Warakorn456/project-sau/wiring_with_float-1.jpg

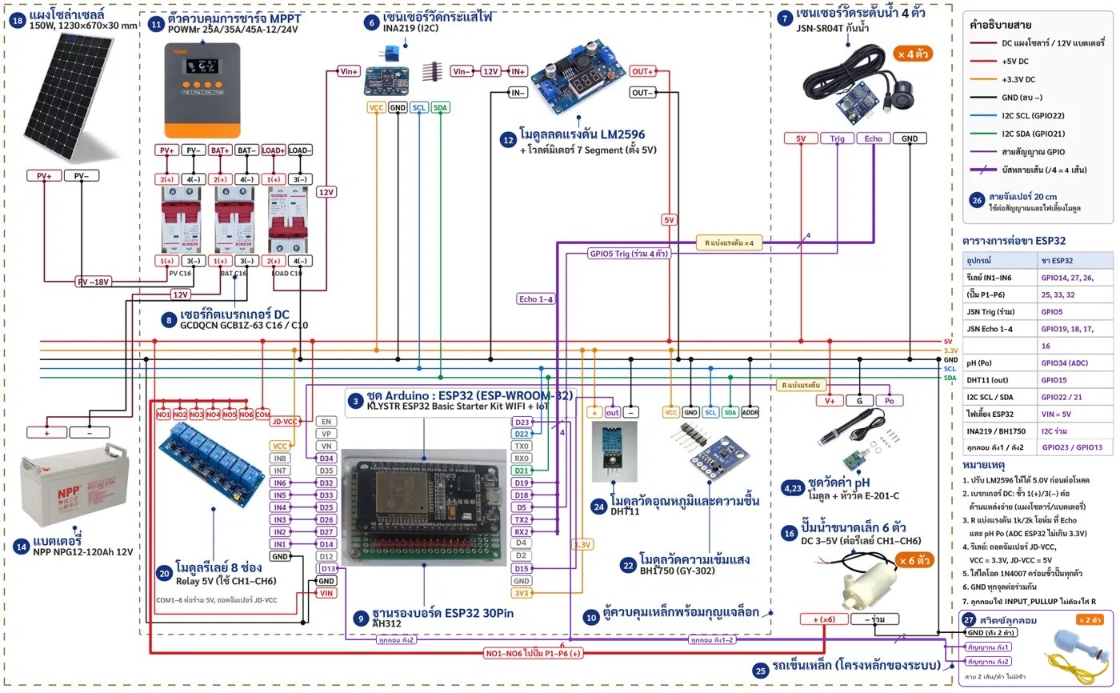
wiring_with_float-1.jpg
