Warakorn456/project-sau/เล่มโปรเจ็ค/รูปบทที่3/part_lm7seg.png

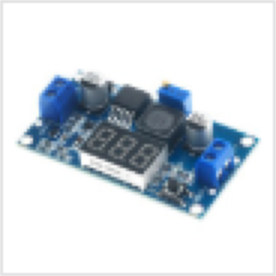
เล่มโปรเจ็ค/รูปบทที่3/part_lm7seg.png
