Warakorn456/project-sau/เล่มโปรเจ็ค/ข้อมูลโปรเจ็ค/Screenshot 2026-10-15 191002.png

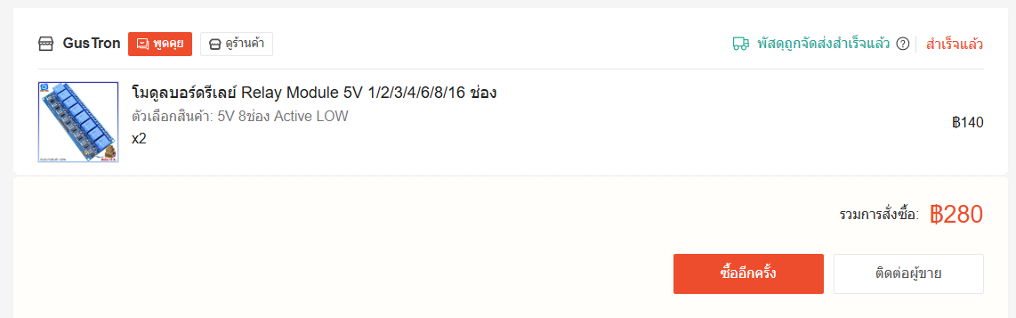
เล่มโปรเจ็ค/ข้อมูลโปรเจ็ค/Screenshot 2026-10-15 191002.png
