Warakorn456/project-sau/เล่มโปรเจ็ค/รูปบทที่3/part_stepdown.png

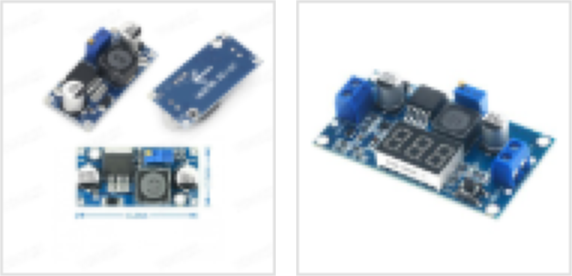
เล่มโปรเจ็ค/รูปบทที่3/part_stepdown.png
