Warakorn456/project-sau/เล่มโปรเจ็ค/รูปบทที่3/web_espboards.png

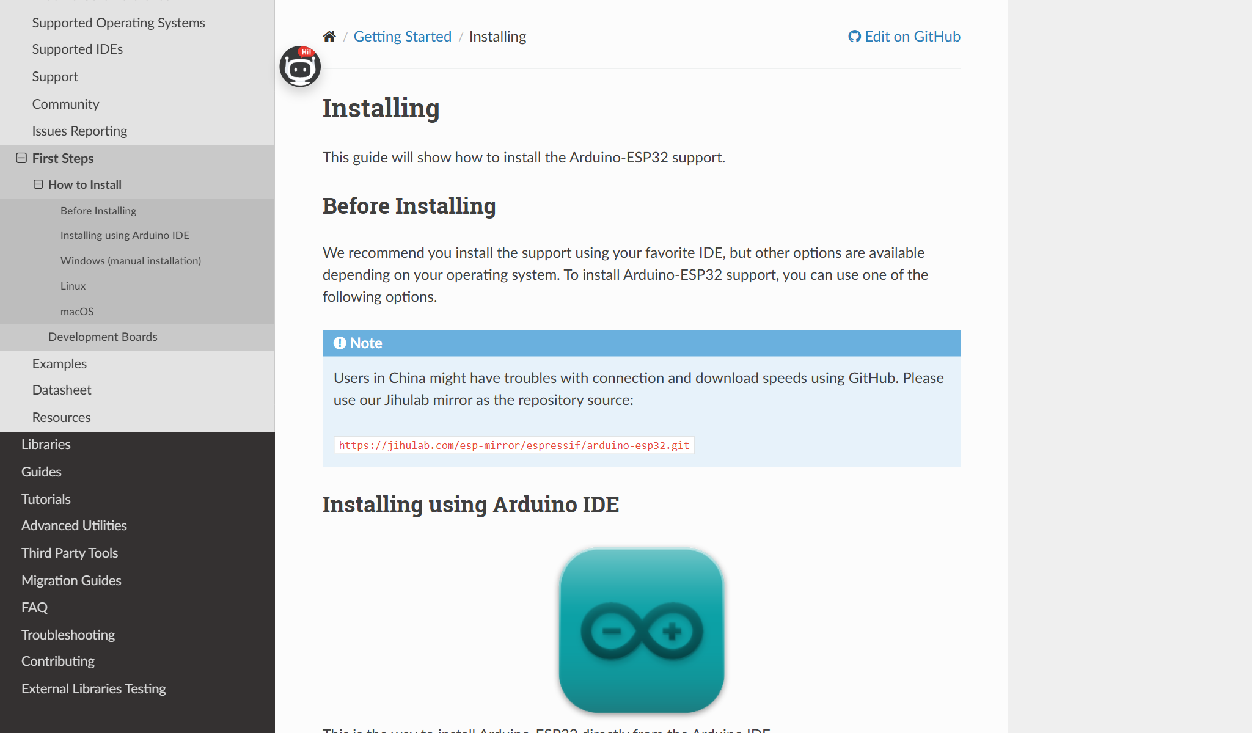
เล่มโปรเจ็ค/รูปบทที่3/web_espboards.png
