Warakorn456/project-sau/wiring_diagram.png

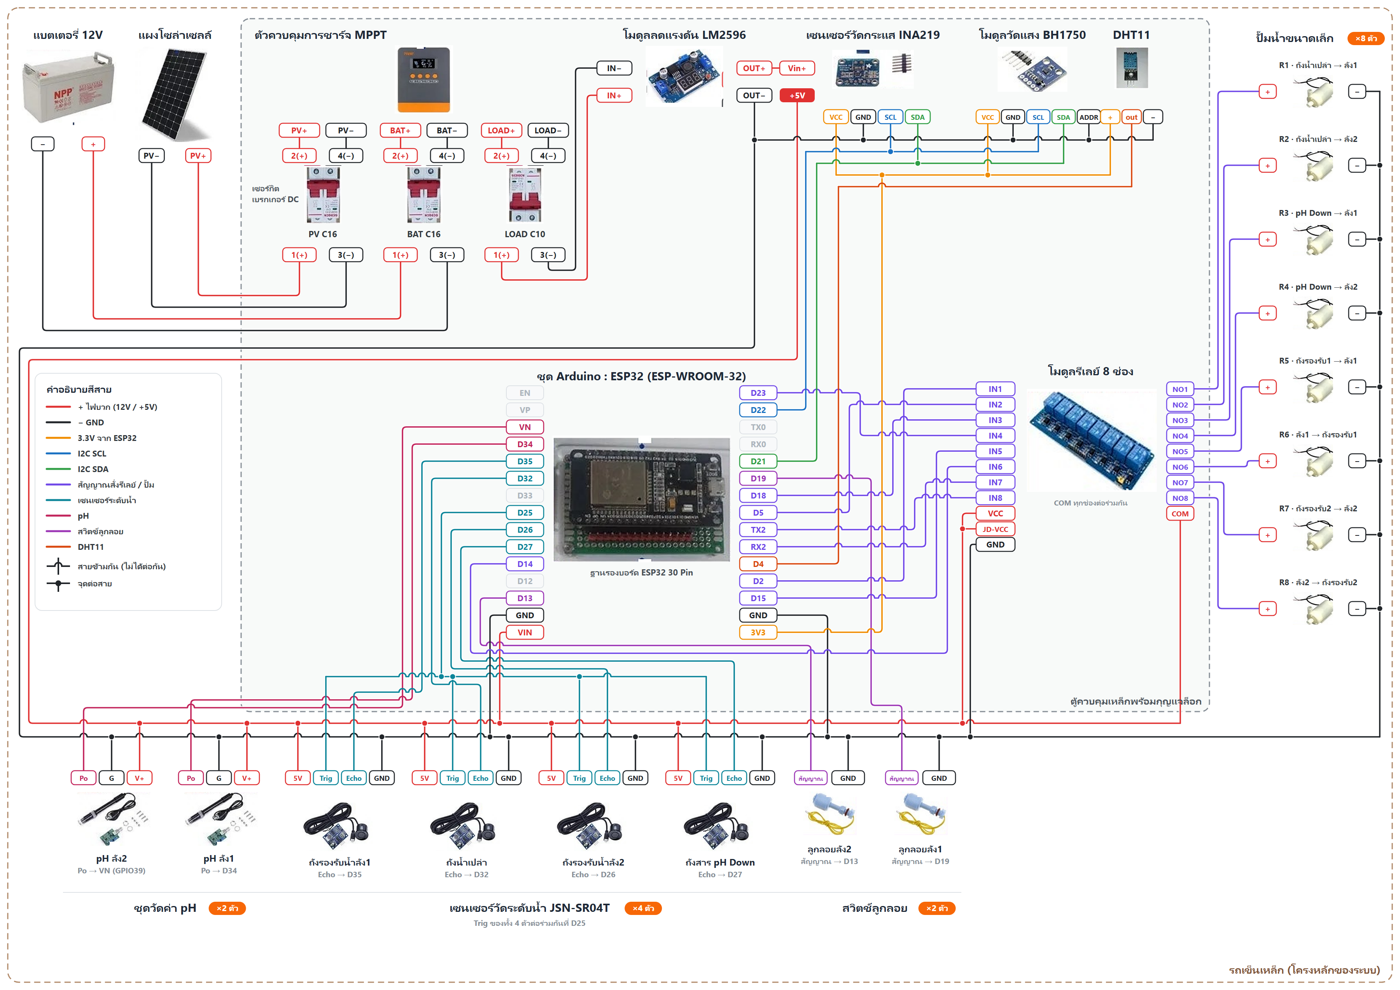
wiring_diagram.png
