Warakorn456/project-sau/เล่มโปรเจ็ค/การทำงานของอุปกรณ์.pdf

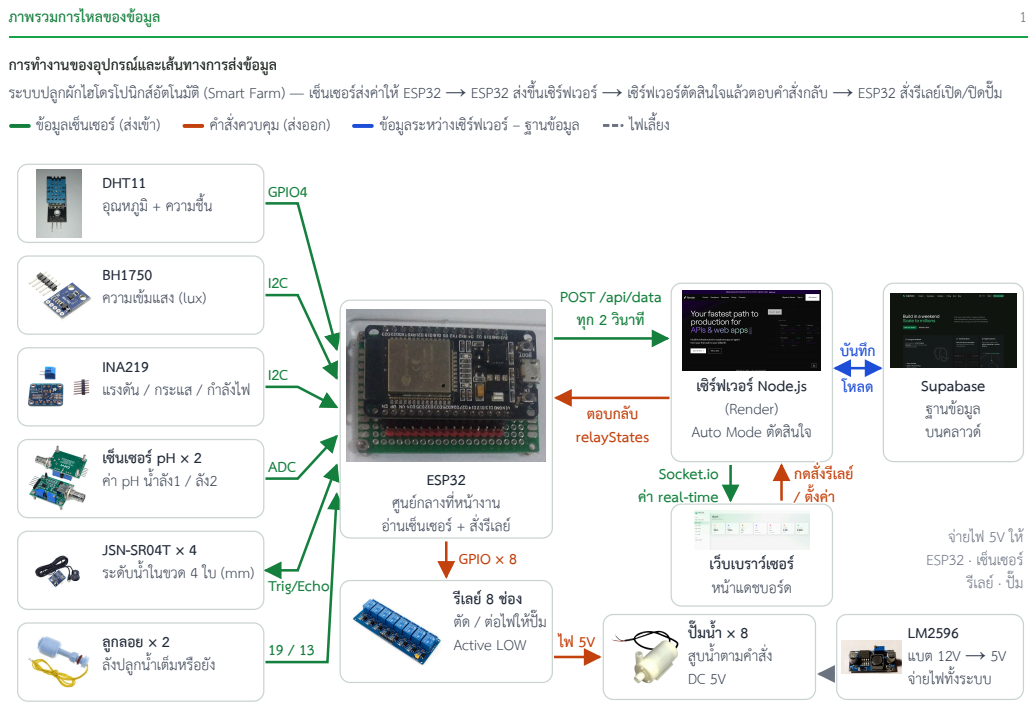
[picture p319: page 1]
ภาพรวมการไหลของข้อมูล; ข้อมูลเซ็นเซอร์ (ส่งเข้า); คำสั่งควบคุม (ส่งออก); ข้อมูลระหว่างเซิร์ฟเวอร์ – ฐานข้อมูล; ไฟเลี้ยง; DHT11 อุณหภูมิ + ความชื้น; GPIIO4; ADC; TTrriigg//EEcchhoo; ลูกลอย × 2; ตตออบบกกลัลัลับลับ rreellaayySSttaatteess; Supabase ฐานข้อมูล บนคลาวด์; กกดดสั่สั่สั่งสั่; รีเลย์ 8 ช่อง ตัด / ต่อไฟให้ปั๊ม Active LOW; GGPPIIOO ×× 88; สูบน้ำ ตามคำสั่ง DC 5V; ไไฟ 5V; LM2596 แบต 12V → 5V จ่ายไฟทั้งระบบ; จ่ายไฟ 5V ให้ ESP32 · เซ็นเซอร์; รีเลย์ · ปั๊ม

การทำ งานของอุปกรณ์และเส้นทางการส่งข้อมูล
ระบบปลูกผักไฮโดรโปนิกส์อัตโนมัติ (Smart Farm) — เซ็นเซอร์ส่งค่าให้ESP32 → ESP32 ส่งขึ้นเซิร์ฟเวอร์ → เซิร์ฟเวอร์ตัดสินใจแล้วตอบคำสั่งกลับ → ESP32 สั่งรีเลย์เปิด/ปิดปั๊ม

ความเข้มแสง (lux)

POST /api/data

ทุทุทุกทุก 22 วิวิวินวินาาทีทีทีที

โโหหลด

INA219
แรงดัน / กระแส / กำ ลังไฟ

เซิร์ฟเวอร์ Node.js
(Render)
Auto Mode ตัดสินใจ
Socket.io
ค่ค่ค่าค่า real-time

เซ็นเซอร์ pH × 2

ESP32
ศูนย์กลางที่หน้างาน
อ่านเซ็นเซอร์ + สั่งรีเลย์

งรีรีรีเรีเลลย์ย์ย์ย์

JSN-SR04T × 4
ระดับน้ำ ในขวด 4 ใบ (mm)

เว็บเบราว์เซอร์
หน้าแดชบอร์ด

ลังปลูกน้ำ เต็มหรือยัง

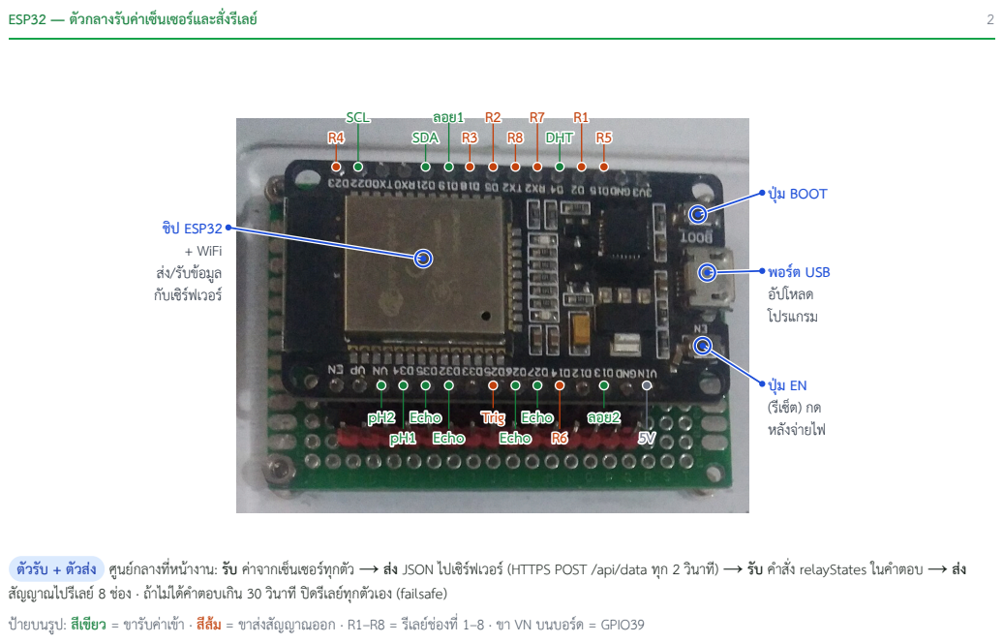
[picture p320: page 2]

ชิชิชิปชิป EESSPP3232
++ WWiiFFii
ส่ส่ส่งส่ง//รัรัรับรับข้ข้ข้ออมูมูมูลล

กักักับกับเเซิซิซิร์ซิร์ร์ฟร์ฟเเววออร์ร์ร์ร์

ปุ่ปุ่ปุ่มปุ่ม EENN
((รีรีรีเรีเซ็ซ็ซ็ตซ็ต)) กกดด
หหลัลัลังลังจ่จ่จ่าจ่ายยไไฟฟ

ตัวรับ + ตัวส่ง ศูนย์กลางที่หน้างาน: รับ ค่าจากเซ็นเซอร์ทุกตัว → ส่ง JSON ไปเซิร์ฟเวอร์ (HTTPS POST /api/data ทุก 2 วินาที) → รับ คำสั่ง relayStates ในคำตอบ → ส่ง
สัญญาณไปรีเลย์ 8 ช่อง · ถ้าไม่ได้คำตอบเกิน 30 วินาที ปิดรีเลย์ทุกตัวเอง (failsafe)
ป้ายบนรูป: สีเขียว = ขารับค่าเข้า · สีส้ม = ขาส่งสัญญาณออก · R1–R8 = รีเลย์ช่องที่ 1–8 · ขา VN บนบอร์ด = GPIO39

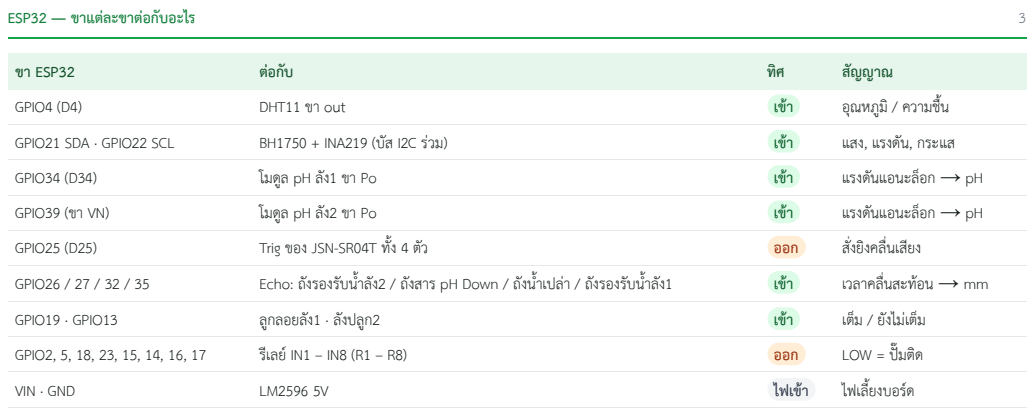
[picture p321: page 3]
ESP32 — ขาแต่ละขาต่อกับอะไร; ขา ESP32; สัญญาณ; GPIO4 (D4); DHT11 ขา out; อุณหภูมิ / ความชื้น; GPIO21 SDA · GPIO22 SCL; BH1750 + INA219 (บัส I2C ร่วม); แสง, แรงดัน, กระแส; GPIO34 (D34); โมดูล pH ลัง1 ขา Po; แรงดันแอนะล็อก → pH; GPIO39 (ขา VN); โมดูล pH ลัง2 ขา Po; GPIO25 (D25); Trig ของ JSN-SR04T ทั้ง 4 ตัว; ออก; สั่งยิงคลื่นเสียง; GPIO26 / 27 / 32 / 35; Echo: ถังรองรับน้ำ ลัง2 / ถังสาร pH Down / ถังน้ำ เปล่า / ถังรองรับน้ำ ลัง1; เวลาคลื่นสะท้อน → mm; GPIO19 · GPIO13; ลูกลอยลัง1 · ลังปลูก2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

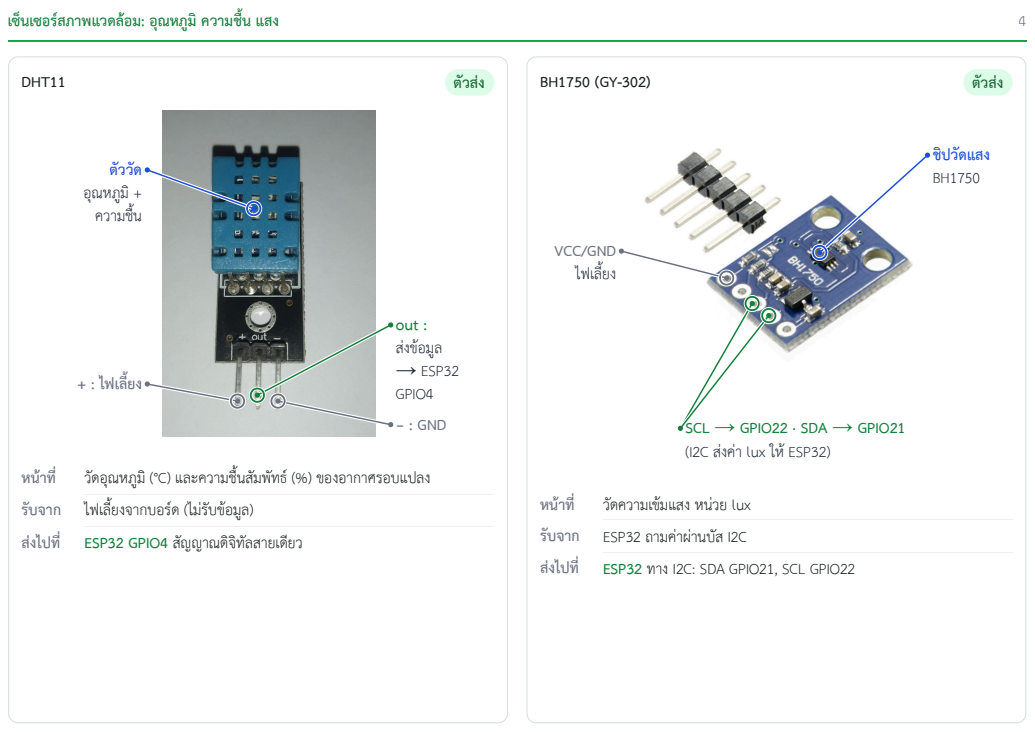
[picture p322: page 4]
เซ็นเซอร์สภาพแวดล้อม: อุณหภูมิ ความชื้น แสง; DHT11; อุอุอุณอุณหหภูภูภูมิภูมิมิมิ; ควควาามมชื้ชื้ชื้นชื้ น; ++ :: ไไฟฟเเลี้ลี้ลี้ยลี้ ยงง; out ::; ส่ส่ส่งส่งข้ข้ →→ EESSPP3322 GPIIO4 −− :: GGNNDD; วัดอุณหภูมิ (°C) และความชื้นสัมพัทธ์ (%) ของอากาศรอบแปลง; ส่งไปที่; ESP32 GPIO4 สัญญาณดิจิทัลสายเดียว; VVCCCC//GGNNDD; ไไฟฟเเลี้ลี้ลี้ยลี้ ยงง; วัดความเข้มแสง หน่วย lux; ESP32 ทาง I2C: SDA GPIO21, SCL GPIO22

ชิชิชิปชิปวัวัวัดวัดแแสสงง
BBHH11775500

SCL → GPIO22 · SDA → GPIO21
(I2C ส่ส่ส่งส่งค่ค่ค่า lux ใให้ห้ESP32))

รับจาก ไฟเลี้ยงจากบอร์ด (ไม่รับข้อมูล)

รับจาก ESP32 ถามค่าผ่านบัส I2C

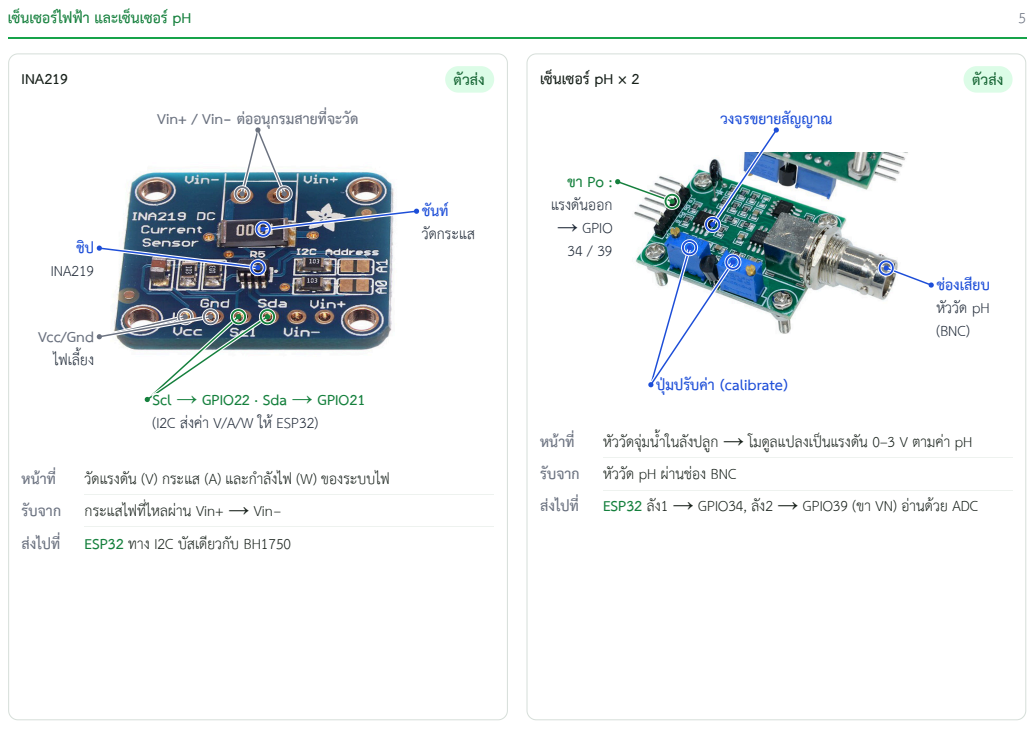
[picture p323: page 5]
เซ็นเซอร์ไฟฟ้า และเซ็นเซอร์ pH; INA219; จะะวัวัวัดวัด; วัวัวัดวัดกกรระะแแสส; ชิปชิ IINNAA221199; VVcccc//GGnndd; ไไฟฟเเลี้ลี้ลี้ยลี้ ยงง; วัดแรงดัน (V) กระแส (A) และกำ ลังไฟ (W) ของระบบไฟ; ส่งไปที่; ESP32 ทาง I2C บัสเดียวกับ BH1750; เซ็นเซอร์ pH × 2; หัววัดจุ่มน้ำ ในลังปลูก → โมดูลแปลงเป็นแรงดัน 0–3 V ตามค่า pH; ESP32 ลัง1 → GPIO34, ลัง2 → GPIO39 (ขา VN) อ่านด้วย ADC

VViinn++ // VViinn−− ต่ต่ต่อต่อออนุนุนุกนุกรรมมสสาายยที่ที่ที่จที่

ววงงจจรรขขยยาายยสัสัสัญสัญญญาาณณ

ขา Po :
แแรรงงดัดัดันดันออออกก
→→ GGPPIIOO

ช่ช่ช่อช่องงเเสีสีสียสียบบ
หัหัวววัวัวัดวัด ppHH
((BNC))

ปุ่ปุ่ปุ่มปุ่มปปรัรัรับรับค่ค่ค่าค่า ((ccaalliibbrraattee))

Scl → GPIO22 · Sda → GPIO21
((II22CC ส่ส่ส่งส่งค่ค่ค่าา VV//AA//WW ใให้ห้EESSPP3322))

รับจาก หัววัด pH ผ่านช่อง BNC

รับจาก กระแสไฟที่ไหลผ่าน Vin+ → Vin−

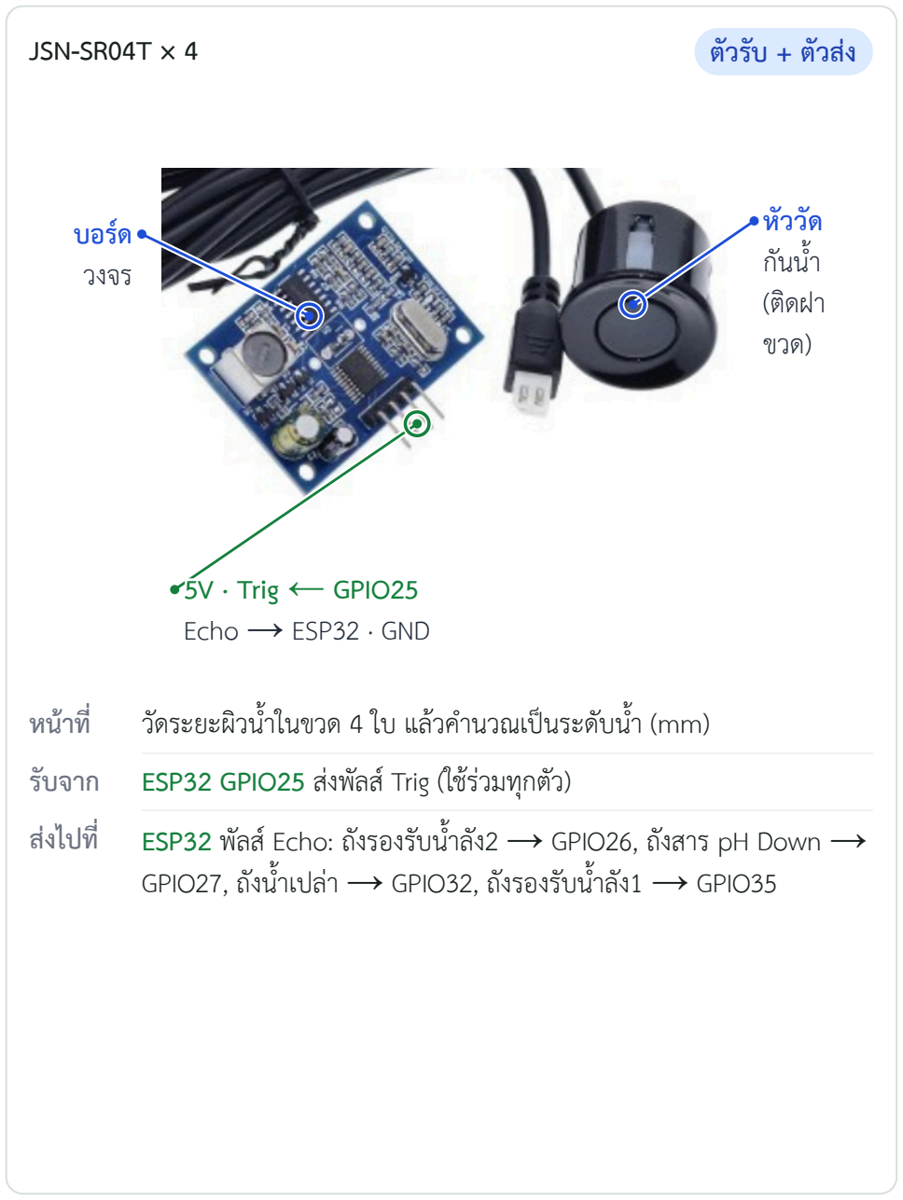
[picture p324: figure]
JSN-SR04T × 4; ((ติติติดติดฝฝาา ขวด)); บออร์ดร์ วงจร; 55VV ·· TTrriigg ←← GGPPIIOO2255 EEcchhoo →→ EESSPP3322 ·· GGNNDD; วัดระยะผิวน้ำ ในขวด 4 ใบ แล้วคำนวณเป็นระดับน้ำ
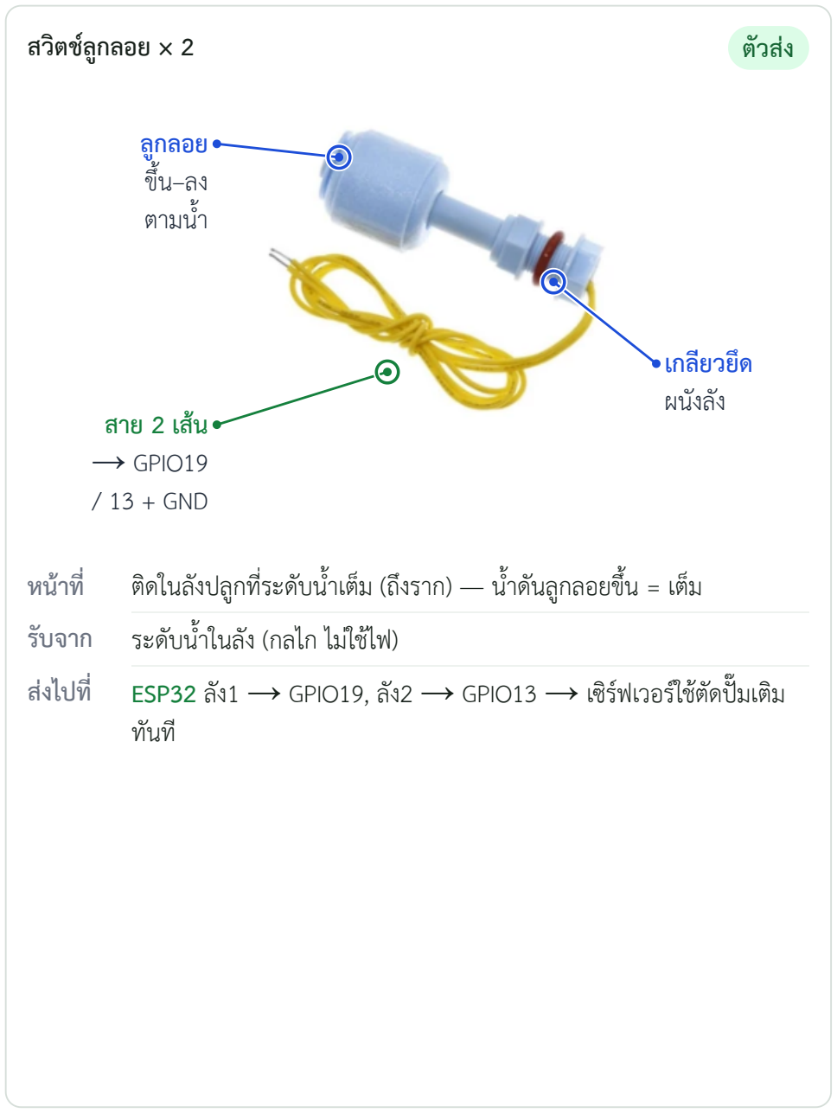
[picture p325: figure]
สวิตช์ลูกลอย × 2; ลูลูลูกลูกลลออยย; น––ลลงง; ตาามน้ำน้ำ; เเกกลีลีลียลียววยึยึยึดยึด; ผผนันันังนังลัลัลังลัง; สสาายย 22 เเส้ส้ส้นส้น →→ GGPPIIOO1199 // 1133 ++ GGNNDD; รับจาก ระดับน้ำ ในลัง (กลไก ไม่ใช้ไฟ)

เซ็นเซอร์ระดับน้ำ : ขวด 4 ใบ และลังปลูก 2 ลัง | 6

รับจาก ESP32 GPIO25 ส่งพัลส์ Trig (ใช้ร่วมทุกตัว)
ส่งไปที่ | ESP32 พัลส์ Echo: ถังรองรับน้ำ ลัง2 → GPIO26, ถังสาร pH Down → GPIO27, ถังน้ำ เปล่า → GPIO32, ถังรองรับน้ำ ลัง1 → GPIO35
หน้าที่ | ติดในลังปลูกที่ระดับน้ำ เต็ม (ถึงราก) — น้ำ ดันลูกลอยขึ้น = เต็ม
ส่งไปที่ | ESP32 ลัง1 → GPIO19, ลัง2 → GPIO13 → เซิร์ฟเวอร์ใช้ตัดปั๊มเติม

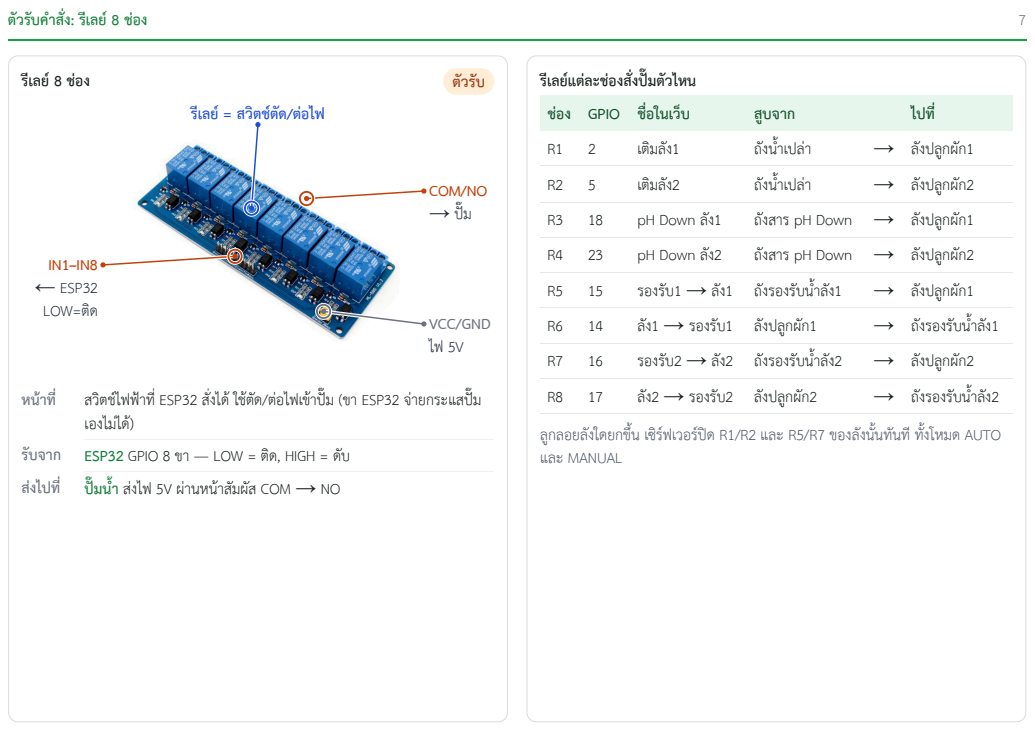
[picture p326: page 7]

รีเลย์แต่ละช่องสั่งปั๊มตัวไหน

รีรีรีเรีเลลย์ย์ย์ย์== สสวิวิวิตวิตช์ช์ช์ตัช์ตัตัดตัด//ต่ต่ต่อต่อไไฟฟ

ลูกลอยลังใดยกขึ้น เซิร์ฟเวอร์ปิด R1/R2 และ R5/R7 ของลังนั้นทันที ทั้งโหมด AUTO
และ MANUAL

เองไม่ได้)
รับจาก ESP32 GPIO 8 ขา — LOW = ติด, HIGH = ดับ

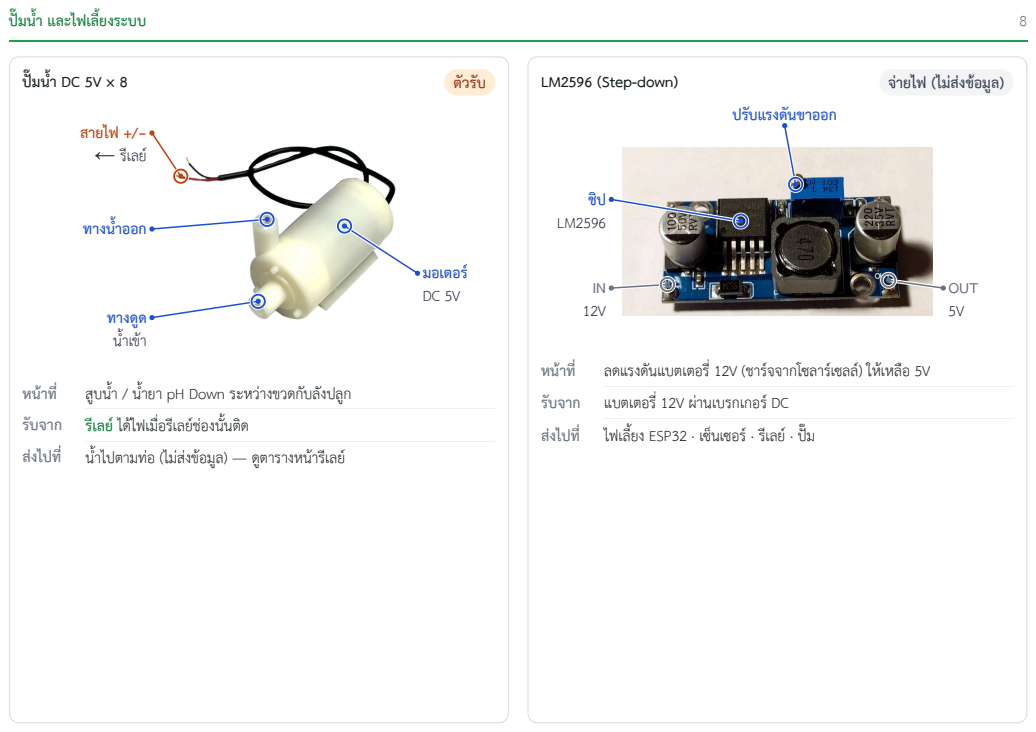
[picture p327: page 8]
และไฟเลี้ยงระบบ; สสาายยไไฟฟ ++//−−; ←← รีรีรีเรีเลลย์ย์ย์ย์; ททาางงดูดูดูดดูด; มมออเเตตออร์ร์ร์ร์ DC 5V; / น้ำ ยา pH Down ระหว่างขวดกับลังปลูก; ส่งไปที่; น้ำ ไปตามท่อ (ไม่ส่งข้อมูล) — ดูตารางหน้ารีเลย์; LM2596 (Step-down); จ่ายไฟ (ไม่ส่งข้อมูล); IIN 12V; OUT 5V; ชิปชิ LLMM22559966; ลดแรงดันแบตเตอรี่ 12V (ชาร์จจากโซลาร์เซลล์) ให้เหลือ 5V; ไฟเลี้ยง ESP32 · เซ็นเซอร์ · รีเลย์ · ปั๊ม

ปปรัรัรับรับแแรรงงดัดัดันดันขขาาออออกก

ททาางงน้ำน้ำน้ำน้ำออออกก

น้ำน้ำน้ำน้ำเเข้ข้

รับจาก แบตเตอรี่ 12V ผ่านเบรกเกอร์ DC

รับจาก รีเลย์ ได้ไฟเมื่อรีเลย์ช่องนั้นติด

ส่วนบนคลาวด์: เซิร์ฟเวอร์ ฐานข้อมูล หน้าเว็บ | 9

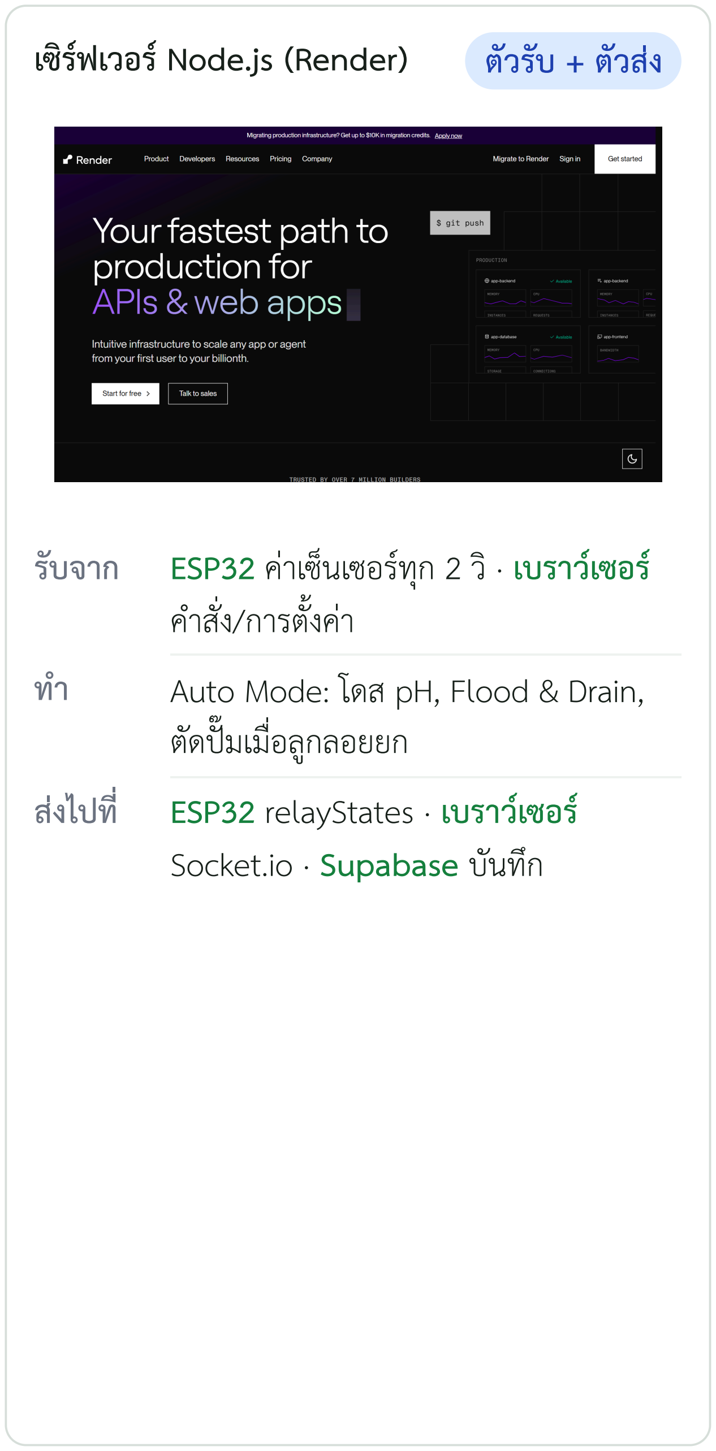
[picture p328: figure]
เซิร์ฟเวอร์ Node.js (Render); คำสั่ง/การตั้งค่า; Auto Mode: โดส pH, Flood & Drain,; ตัดปั๊มเมื่อลูกลอยยก; ส่งไปที่; ESP32 relayStates · เบราว์เซอร์; Socket.io · Supabase บันทึก
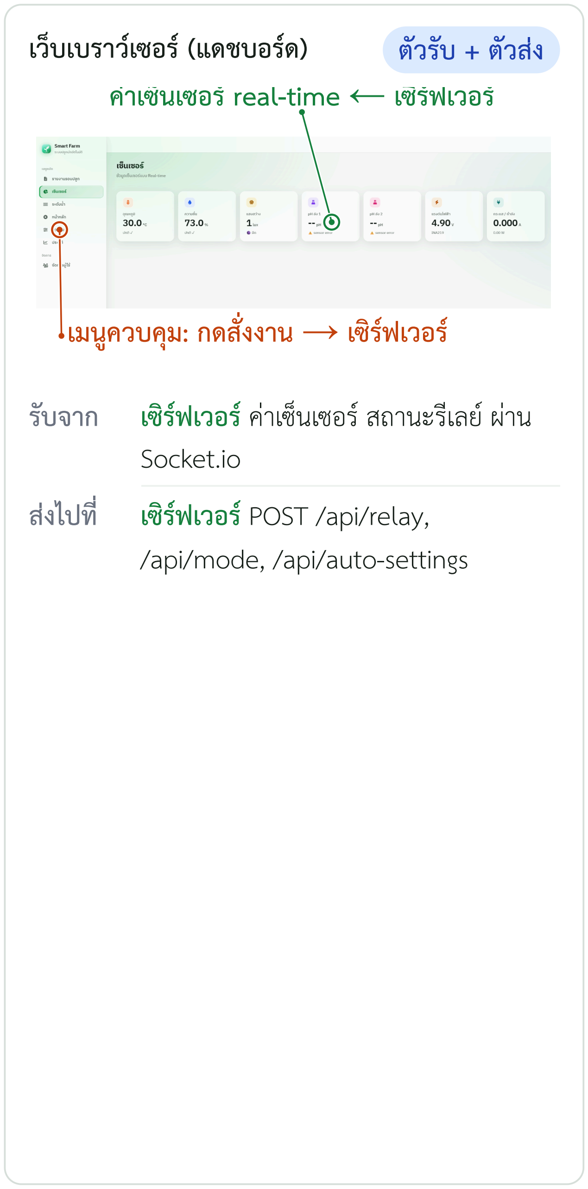
[picture p329: figure]
เว็บเบราว์เซอร์ (แดชบอร์ด); ค่ค่ค่าค่าเเซ็ซ็ซ็นซ็นเเซซออร์ร์ร์ร์rreeaall--ttiimmee ←← เเซิซิซิร์ซิร์ร์ฟร์ฟเเววออร์ร์ร์ร์; เเมมนูนูนูคนูคววบบคุคุคุมคุม:: กกดดสั่สั่สั่ง สั่; งงงาานน →→ เเซิซิซิร์ซิร์ร์ฟร์ฟเเววออร์ร์ร์ร์; รับจาก เซิร์ฟเวอร์ ค่าเซ็นเซอร์ สถานะรีเลย์ ผ่าน Socket.io; ส่งไปที่; เซิร์ฟเวอร์ POST /api/relay,; /api/mode, /api/auto-settings

รับจาก ESP32 ค่าเซ็นเซอร์ทุก 2 วิ · เบราว์เซอร์

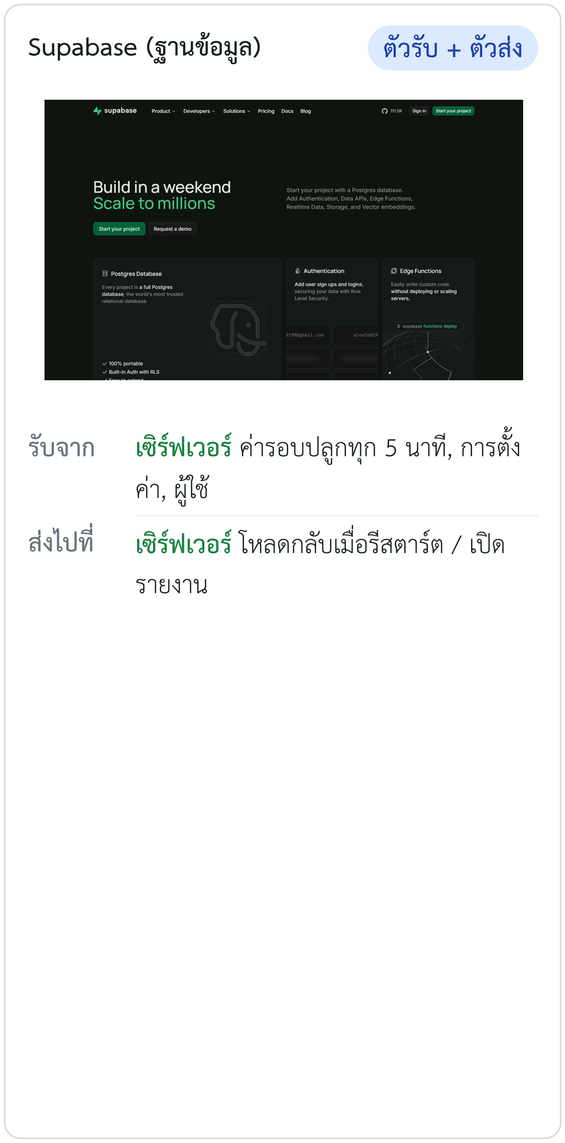
[picture p330: figure]
Supabase (ฐานข้อมูล); ส่งไปที่; เซิร์ฟเวอร์ โหลดกลับเมื่อรีสตาร์ต / เปิด; รายงาน

รับจาก เซิร์ฟเวอร์ ค่ารอบปลูกทุก 5 นาที, การตั้ง

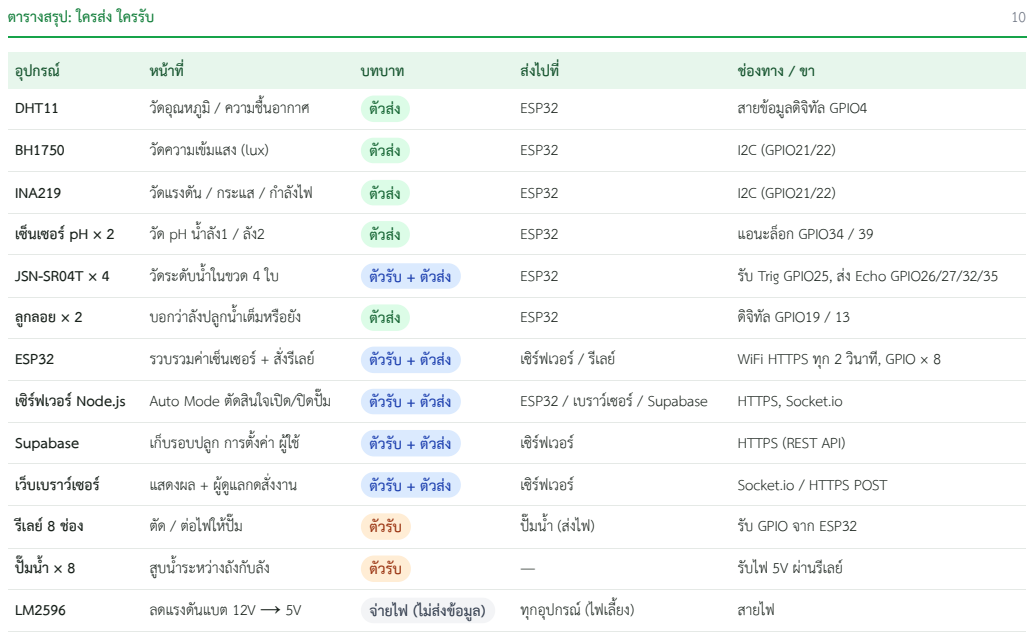
[picture p331: page 10]
ตารางสรุป: ใครส่ง ใครรับ; อุปกรณ์; บทบาท; ส่งไปที่; ช่องทาง / ขา; DHT11; วัดอุณหภูมิ / ความชื้นอากาศ; ESP32; สายข้อมูลดิจิทัล GPIO4; วัดความเข้มแสง (lux); I2C (GPIO21/22); INA219; วัดแรงดัน / กระแส / กำ ลังไฟ; เซ็นเซอร์ pH × 2; แอนะล็อก GPIO34 / 39; JSN-SR04T × 4; วัดระดับน้ำ ในขวด 4 ใบ; รับ Trig GPIO25, ส่ง Echo GPIO26/27/32/35; ลูกลอย × 2; บอกว่าลังปลูกน้ำ เต็มหรือยัง; ดิจิทัล GPIO19 / 13; รวบรวมค่าเซ็นเซอร์ + สั่งรีเลย์; เซิร์ฟเวอร์ / รีเลย์; WiFi HTTPS ทุก 2 วินาที, GPIO × 8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
