Warakorn456/project-sau/เล่มโปรเจ็ค/ข้อมูลเก่า/การทำงานของอุปกรณ์ (IBM Plex).pdf

ภาพรวมการไหลของข้อมูล | 1

## การทำ งานของอุปกรณ์และเส้นทางการส่งข้อมูล

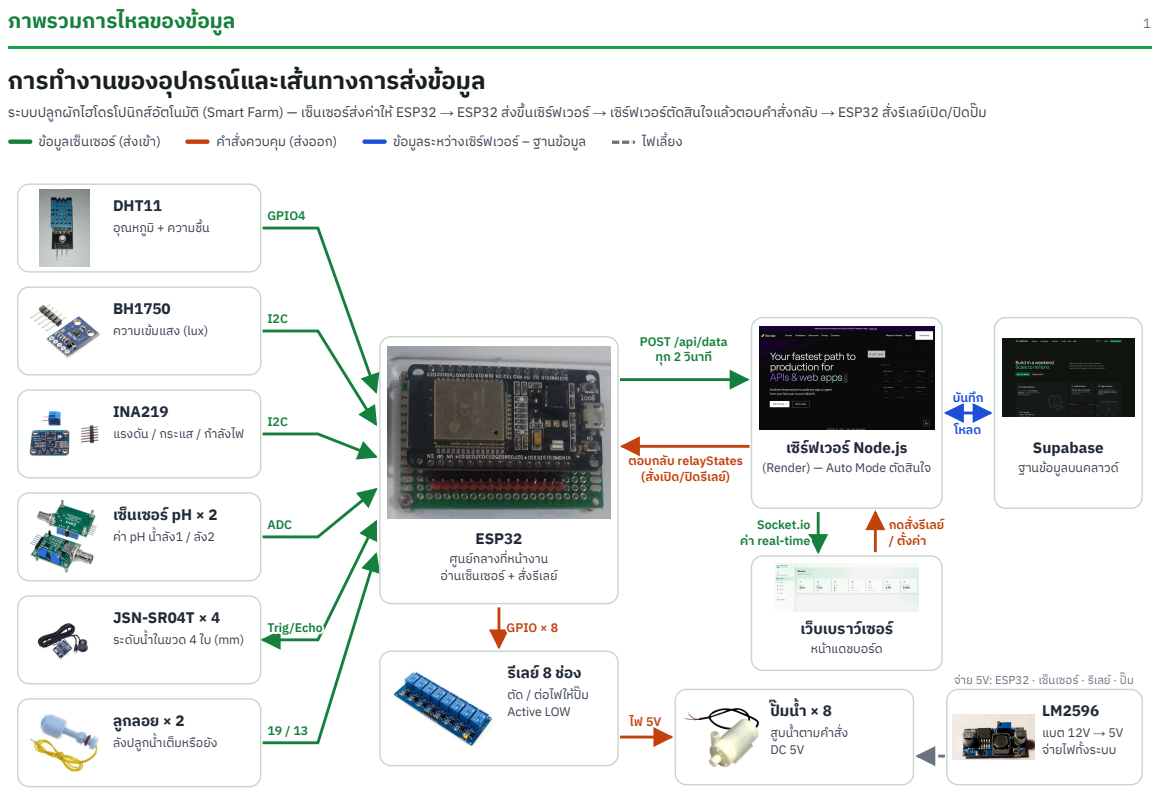
[picture p332: page 1]
ข้อมูลเซ็นเซอร์ (ส่งเข้า); คำ สั่งควบคุม (ส่งออก); ข้อมูลระหว่างเซิร์ฟเวอร์ – ฐานข้อมูล; ไฟเลี้ยง; DHT11; อุณหภูมิ + ความชื้น; GPIO4; ADC; TTrriigg//EEcchoho; ลูกลอย × 2; ((สั่สั่สั่สั่งงเเปิปิปิปิ; ดดรีรีรีรีเเลลย์ย์ย์ย์)); บับับับันนทึทึทึทึกก; โหลด; รีเลย์ 8 ช่อง ตัด / ต่อไฟให้ปั๊ม Active LOW; GPGPIIO O ×× 88; สูบน้ำ ตามคำ สั่ง DC 5V; LM2596 แบต 12V → 5V จ่ายไฟทั้งระบบ

ระบบปลูกผักไฮโดรโปนิกส์อัตโนมัติ (Smart Farm) — เซ็นเซอร์ส่งค่าให้ ESP32 → ESP32 ส่งขึ้นเซิร์ฟเวอร์ → เซิร์ฟเวอร์ตัดสินใจแล้วตอบคำ สั่งกลับ → ESP32 สั่งรีเลย์เปิด/ปิดปั๊ม

ความเข้มแสง (lux)

POST /api/data
ทุทุทุทุกก 22 วิวิวิวินนาาทีทีทีที

INA219
แรงดัน / กระแส / กำ ลังไฟ

เซิร์ฟเวอร์ Node.js
(Render) — Auto Mode ตัดสินใจ

Supabase
ฐานข้อมูลบนคลาวด์

ตตออบบกกลัลัลัลับบ rreelalayySSttaatteess

เซ็นเซอร์ pH × 2

Socket.io
ค่ค่ค่ค่า real-time

กกดดสั่สั่สั่สั่งงรีรีรีรีเเลลย์ย์ย์ย์
// ตั้ตั้ตั้ตั้งงค่ค่ค่ค่าา

ESP32
ศูนย์กลางที่หน้างาน

อ่านเซ็นเซอร์ + สั่งรีเลย์

JSN-SR04T × 4
ระดับน้ำ ในขวด 4 ใบ (mm)

เว็บเบราว์เซอร์
หน้าแดชบอร์ด

จ่าย 5V: ESP32 · เซ็นเซอร์ · รีเลย์ · ปั๊ม

ลังปลูกน้ำ เต็มหรือยัง

ESP32 — ตัวกลางรับค่าเซ็นเซอร์และสั่งรีเลย์ | 2

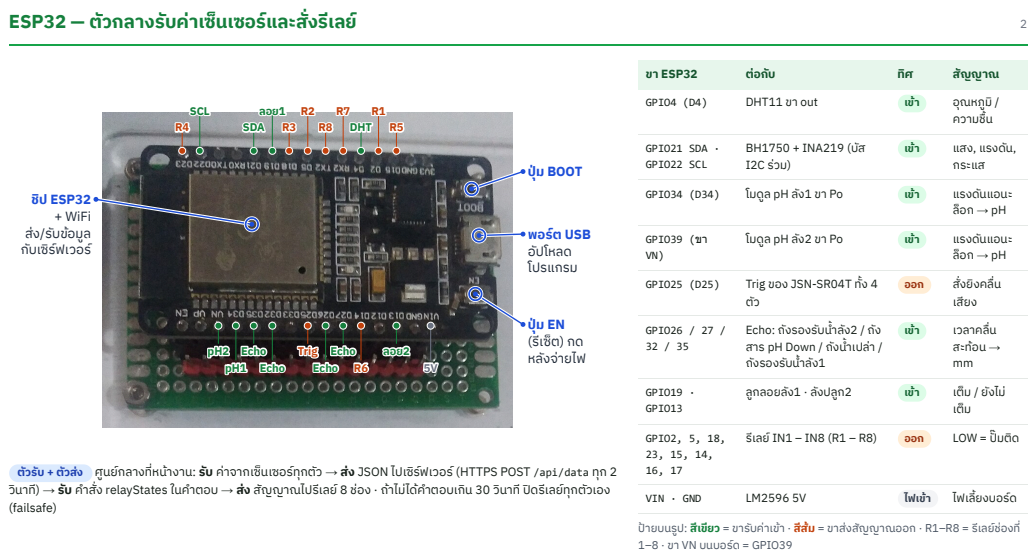
[picture p333: page 2]

ชิชิชิชิปป EESSPP3322
++ WWiiFFii
ส่ส่ส่ส่งง//รัรัรัรับบข้ข้ข้ข้ออมูมูมูมูลล
กักักักับบเเซิซิซิซิร์ร์ร์ร์ฟฟเเววออร์ร์ร์ร์

Echo: ถังรองรับน้ำ ลัง2 / ถัง
สาร pH Down / ถังน้ำ เปล่า /

GPIO2, 5, 18,
ป้ายบนรูป: สีเขียว = ขารับค่าเข้า · สีส้ม = ขาส่งสัญญาณออก · R1–R8 = รีเลย์ช่องที่
1–8 · ขา VN บนบอร์ด = GPIO39

ตัวรับ + ตัวส่ง ศูนย์กลางที่หน้างาน: รับ ค่าจากเซ็นเซอร์ทุกตัว → ส่ง JSON ไปเซิร์ฟเวอร์ (HTTPS POST /api/data ทุก 2
วินาที) → รับ คำ สั่ง relayStates ในคำ ตอบ → ส่ง สัญญาณไปรีเลย์ 8 ช่อง · ถ้าไม่ได้คำ ตอบเกิน 30 วินาที ปิดรีเลย์ทุกตัวเอง
(failsafe)

เซ็นเซอร์สภาพแวดล้อม: อุณหภูมิ ความชื้น แสง | 3

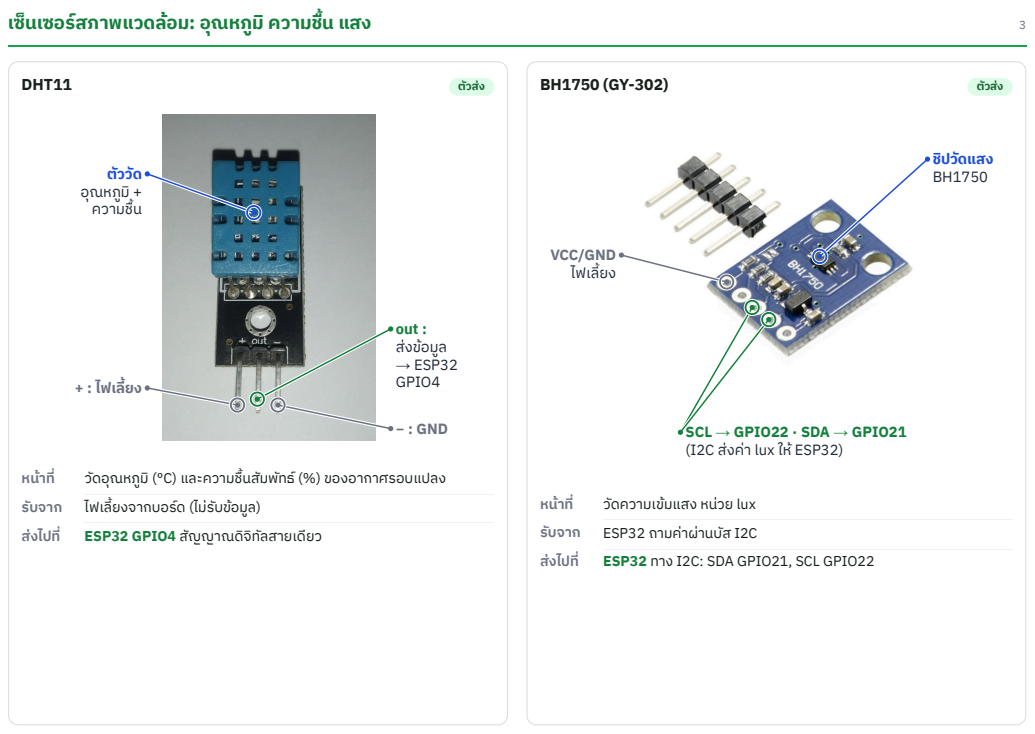
[picture p334: page 3]
DHT11; ตัตัตัตัวววัวัวัวัดด; อุอุณณหหภูภู; คคววาามมชื้ชื้ชื้ชื้ นน; ++ :: ไไฟฟเเลี้ลี้ลี้ลี้ยยงง; out ::; ส่ส่ส่ส่งงข้ข้; ข้ข้ออมูมู; มูมูลล →→ EESSPP3322 GPIO4; −− :: GGNNDD; วัดอุณหภูมิ (°C) และความชื้นสัมพัทธ์ (%) ของอากาศรอบแปลง; ส่งไปที่; ESP32 GPIO4 สัญญาณดิจิทัลสายเดียว; ชิชิชิชิปปวัวัวัวัดดแแสสงง BH1750; VVCCCC//GGNNDD; ไไฟฟเเลี้ลี้ลี้ลี้ยยงง; ห้ห้EESSPP3322)); วัดความเข้มแสง หน่วย lux; ESP32 ทาง I2C: SDA GPIO21, SCL GPIO22

SSCCLL →→ GGPPIIOO2222 ·· SSDDA A →→ GGPPIIOO2211
((II22CC ส่ส่ส่ส่งงค่ค่ค่ค่าา lluuxx ใให้ห้

รับจาก ไฟเลี้ยงจากบอร์ด (ไม่รับข้อมูล)

รับจาก ESP32 ถามค่าผ่านบัส I2C

เซ็นเซอร์ไฟฟ้า และเซ็นเซอร์ pH | 4

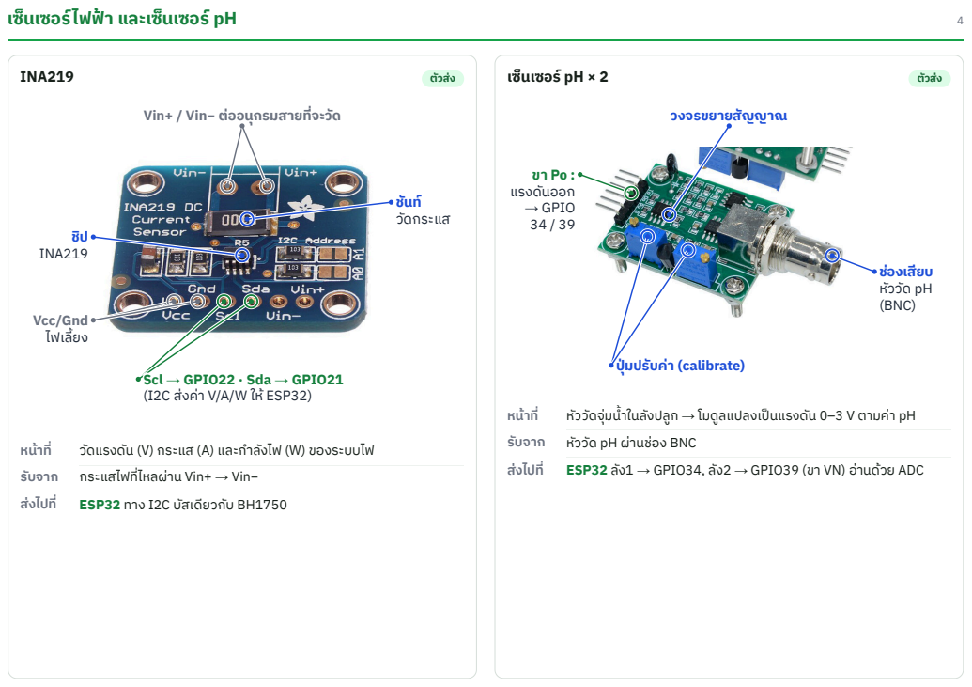
[picture p335: page 4]
INA219; ชันท์ วัวัวัวัดดกกรระะแแสส; ชิป INA219; VVcccc//GGnndd; ไไฟฟเเลี้ลี้ลี้ลี้ยยงง; ห้ห้EESSPP3322)); วัดแรงดัน (V) กระแส (A) และกำ ลังไฟ (W) ของระบบไฟ; ส่งไปที่; ESP32 ทาง I2C บัสเดียวกับ BH1750; เซ็นเซอร์ pH × 2; ขขาา PPoo :: แแรรงงดัดัดัดันนออออกก →→ GGPPIIOO 3344 // 3399; ววงงจจรรขขยยาายยสัสัสัสัญญญญาาณณ; หัววัดจุ่มน้ำ ในลังปลูก → โมดูลแปลงเป็นแรงดัน 0–3 V ตามค่า pH; ESP32 ลัง1 → GPIO34, ลัง2 → GPIO39 (ขา VN) อ่านด้วย ADC

VViinn++ // VViinn−− ต่ต่ต่ต่ออออนุนุนุนุกกรรมมสสาายยที่ที่ที่ที่จจะะวัวัวัวัดด

ช่ช่ช่ช่อองงเเสีสีสีสียยบบ
หัหัหัหัวววัวัวัวัดด ppHH
(BNC)

ปุ่ปุ่ปุ่ปุ่ปุ่ปุ่มมปปรัรัรัรับบค่ค่ค่ค่าา ((ccaalliibbrraattee))

Scl → GPIO22 · Sda → GPIO21
((II22CC ส่ส่ส่ส่งงค่ค่ค่ค่าา VV//AA//WW ใให้ห้

รับจาก หัววัด pH ผ่านช่อง BNC

รับจาก กระแสไฟที่ไหลผ่าน Vin+ → Vin−

เซ็นเซอร์ระดับน้ำ : ขวด 4 ใบ และลังปลูก 2 ลัง | 5

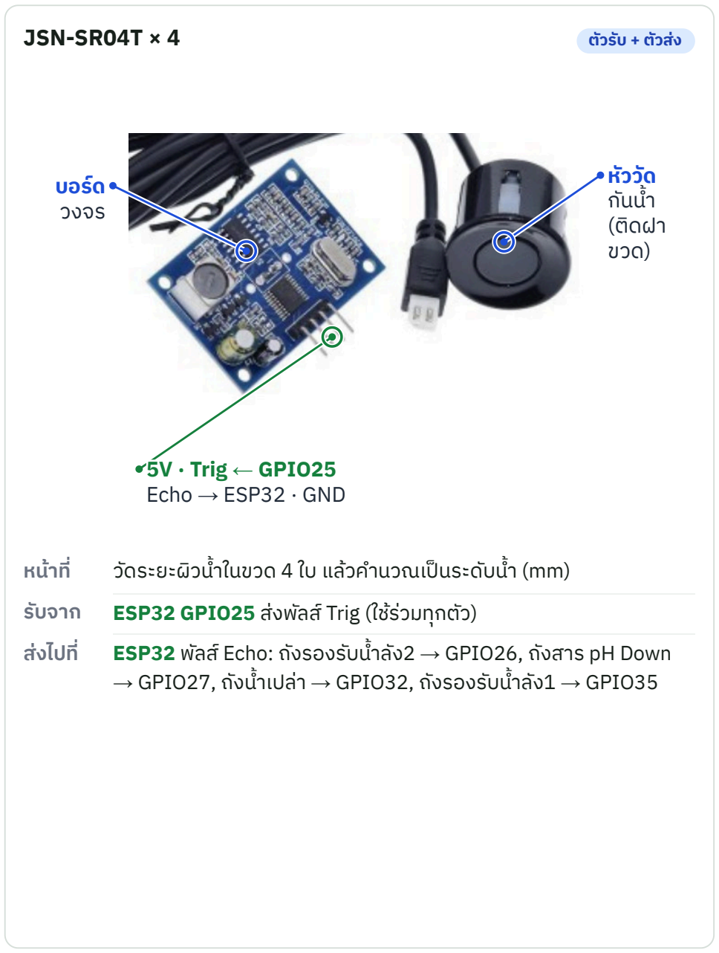
[picture p336: figure]
JSN-SR04T × 4; หัหัหัหัวววัวัวัวัดด; กักักักันนน้ำน้ำน้ำน้ำน้ำน้ำน้ำน้ำ ((ติติติติดดฝฝาา ขวด); บอร์ด วงจร; 55VV ·· TTri rigg ←← GGPPIIOO2255 EEcchhoo →→ EESSPP3322 ·· GGNDND

หน้าที่ | วัดระยะผิวน้ำ ในขวด 4 ใบ แล้วคำ นวณเป็นระดับน้ำ | (mm)
รับจาก ESP32 GPIO25 ส่งพัลส์ Trig (ใช้ร่วมทุกตัว)
ส่งไปที่ ESP32 พัลส์ Echo: ถังรองรับน้ำ ลัง2 → GPIO26, ถังสาร pH Down → GPIO27, ถังน้ำ เปล่า → GPIO32, ถังรองรับน้ำ ลัง1 → GPIO35

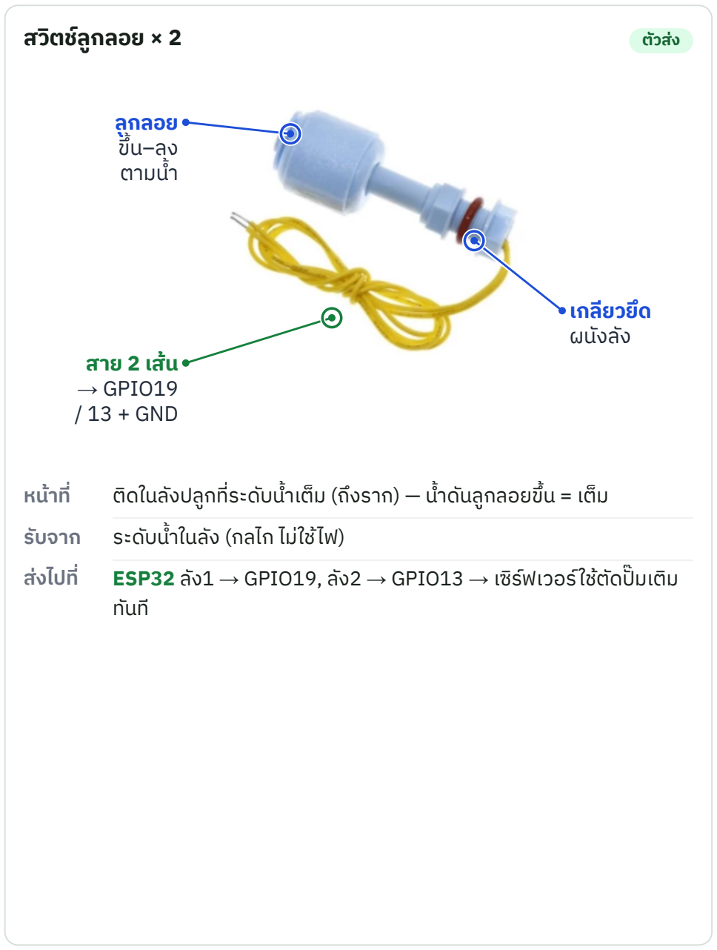
[picture p337: figure]
สวิตช์ลูกลอย × 2; ลูลูลูลูกกลลออยย; ขึ้ขึ้ขึ้ขึ้ขึ้ขึ้นน––ลลงง; ตตาามมน้ำน้ำน้ำน้ำน้ำน้ำน้ำน้ำ; เเกกลีลีลีลียยววยึยึยึยึดด; ผผนันันันังงลัลัลัลังง; สสาายย 22 เเส้ส้ส้ส้นน →→ GGPPIIOO1199 // 1133 ++ GGNDND; รับจาก ระดับน้ำ ในลัง (กลไก ไม่ใช้ไฟ)

หน้าที่ | ติดในลังปลูกที่ระดับน้ำ เต็ม (ถึงราก) — น้ำ ดันลูกลอยขึ้น = เต็ม
ส่งไปที่ | ESP32 ลัง1 → GPIO19, ลัง2 → GPIO13 → เซิร์ฟเวอร์ใช้ตัดปั๊มเติม

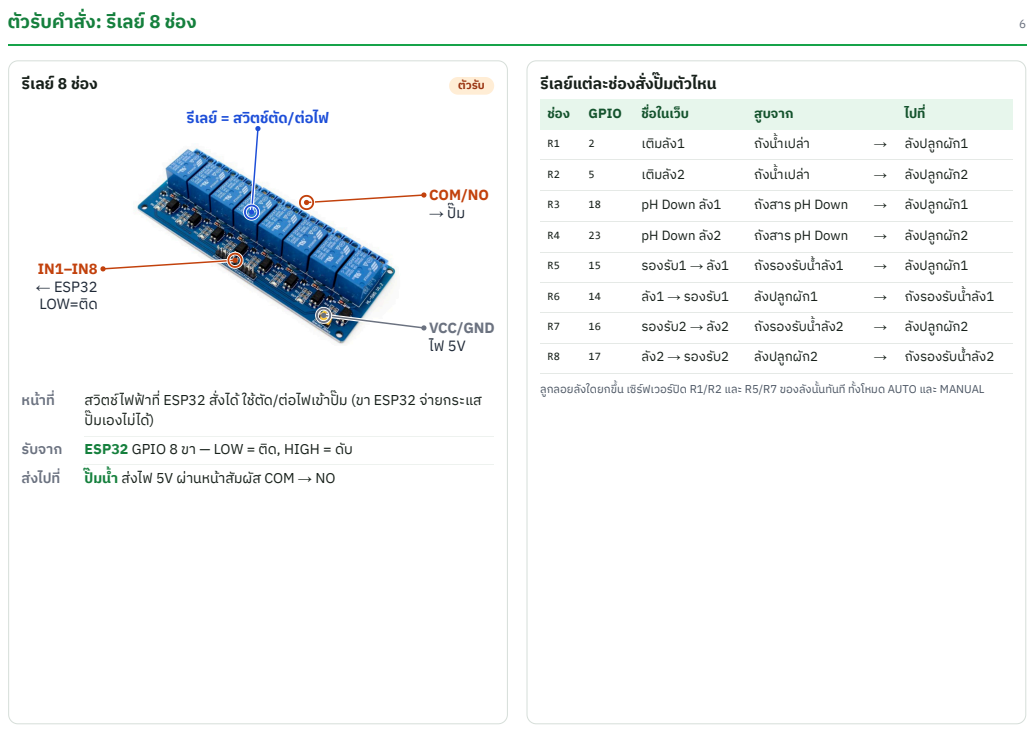
[picture p338: page 6]

รีเลย์แต่ละช่องสั่งปั๊มตัวไหน
ลูกลอยลังใดยกขึ้น เซิร์ฟเวอร์ปิด R1/R2 และ R5/R7 ของลังนั้นทันที ทั้งโหมด AUTO และ MANUAL

รีรีรีรีเเลลย์ย์ย์ย์== สสวิวิวิวิตตช์ช์ช์ช์ตัตัตัตัดด//ต่ต่ต่ต่ออไไฟฟ

ปั๊มเองไม่ได้)
รับจาก ESP32 GPIO 8 ขา — LOW = ติด, HIGH = ดับ

ปั๊มน้ำ | และไฟเลี้ยงระบบ | 7

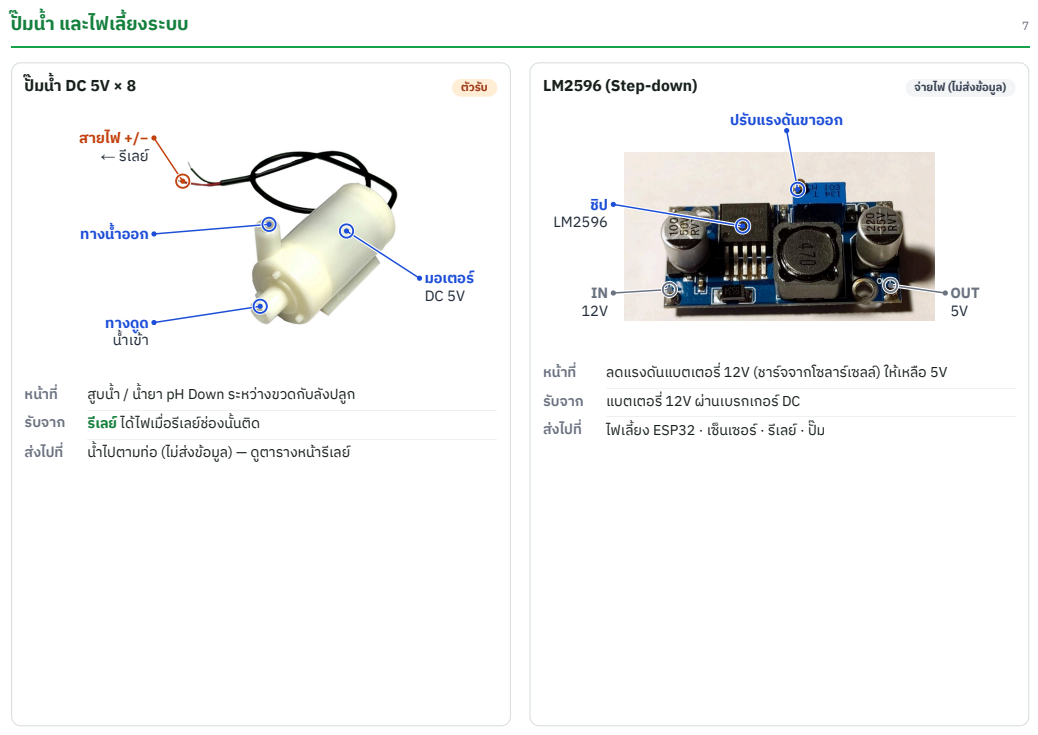
[picture p339: page 7]
สสาายยไไฟฟ ++//−−; ←← รีรีรีรีเเลลย์ย์ย์ย์; มมออเเตตออร์ร์ร์ร์ DC 5V; / น้ำ ยา pH Down ระหว่างขวดกับลังปลูก; ส่งไปที่; น้ำ ไปตามท่อ (ไม่ส่งข้อมูล) — ดูตารางหน้ารีเลย์; LM2596 (Step-down); จ่ายไฟ (ไม่ส่งข้อมูล); OUT 5V; ชิป LLMM22559966; ลดแรงดันแบตเตอรี่ 12V (ชาร์จจากโซลาร์เซลล์) ให้เหลือ 5V; ไฟเลี้ยง ESP32 · เซ็นเซอร์ · รีเลย์ · ปั๊ม

ปปรัรัรัรับบแแรรงงดัดัดัดันนขขาาออออกก

น้ำน้ำน้ำน้ำน้ำน้ำออออกก
ททาางงน้ำน้ำ

ททาางงดูดูดูดูดด
น้ำน้ำน้ำน้ำน้ำน้ำน้ำน้ำเเข้ข้

รับจาก แบตเตอรี่ 12V ผ่านเบรกเกอร์ DC

รับจาก รีเลย์ ได้ไฟเมื่อรีเลย์ช่องนั้นติด

ส่วนบนคลาวด์: เซิร์ฟเวอร์ ฐานข้อมูล หน้าเว็บ | 8

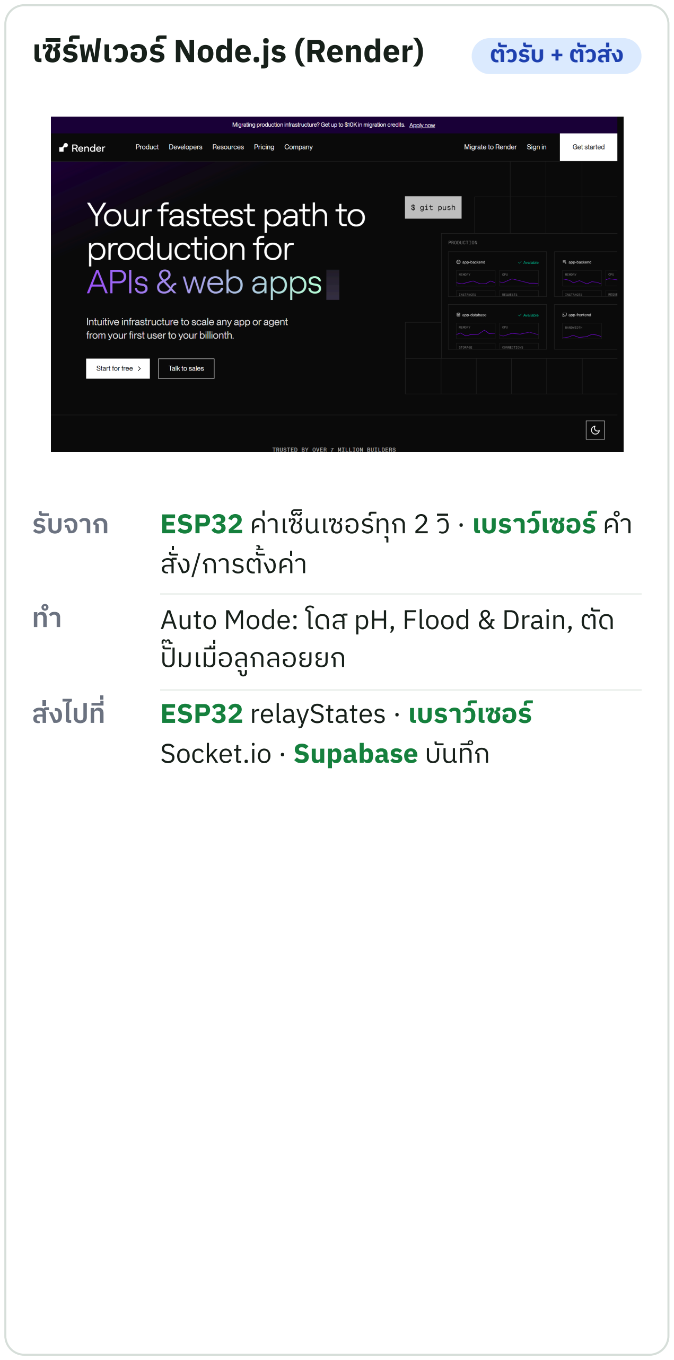
[picture p340: figure]
เซิร์ฟเวอร์ Node.js (Render); สั่ง/การตั้งค่า; ปั๊มเมื่อลูกลอยยก; ส่งไปที่; ESP32 relayStates · เบราว์เซอร์; Socket.io · Supabase บันทึก
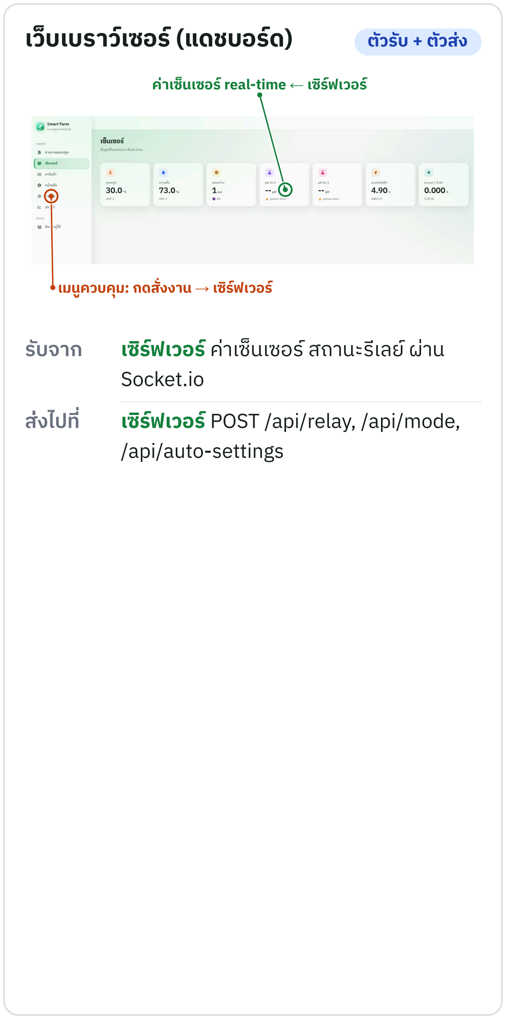
[picture p341: figure]
เว็บเบราว์เซอร์ (แดชบอร์ด); ค่ค่ค่ค่าาเเซ็ซ็ซ็ซ็นนเเซซออร์ร์ร์ร์rreeaall--ttiimmee ←← เเซิซิซิซิร์ร์ร์ร์ฟฟเเววออร์ร์ร์ร์; เเมมนูนูนูนูควควบบคุคุคุคุมม:: กกดดสั่สั่สั่สั่งงงงาานน →→ เเซิซิซิซิร์ร์ร์ร์ฟฟเเววออร์ร์ร์ร์; รับจาก เซิร์ฟเวอร์ ค่าเซ็นเซอร์ สถานะรีเลย์ ผ่าน Socket.io; ส่งไปที่; เซิร์ฟเวอร์ POST /api/relay, /api/mode,; /api/auto-settings

รับจาก ESP32 ค่าเซ็นเซอร์ทุก 2 วิ · เบราว์เซอร์ คำ

ทำ Auto Mode: โดส pH, Flood & Drain, ตัด

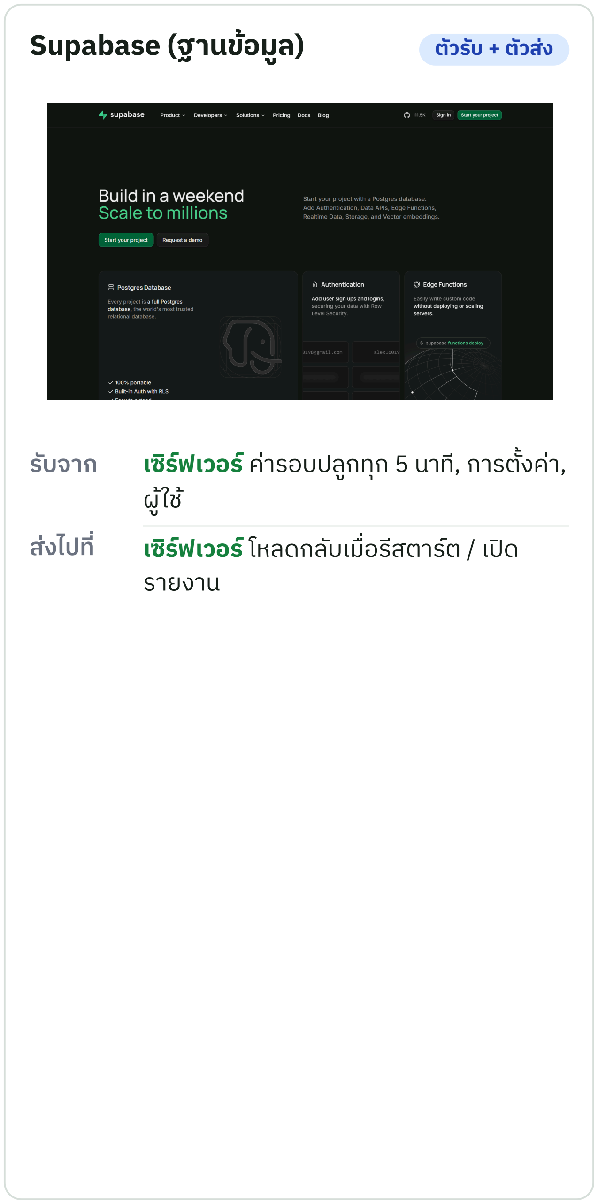
[picture p342: figure]
Supabase (ฐานข้อมูล); ส่งไปที่; เซิร์ฟเวอร์ โหลดกลับเมื่อรีสตาร์ต / เปิด; รายงาน

รับจาก เซิร์ฟเวอร์ ค่ารอบปลูกทุก 5 นาที, การตั้งค่า,

ตารางสรุป: ใครส่ง ใครรับ | 9

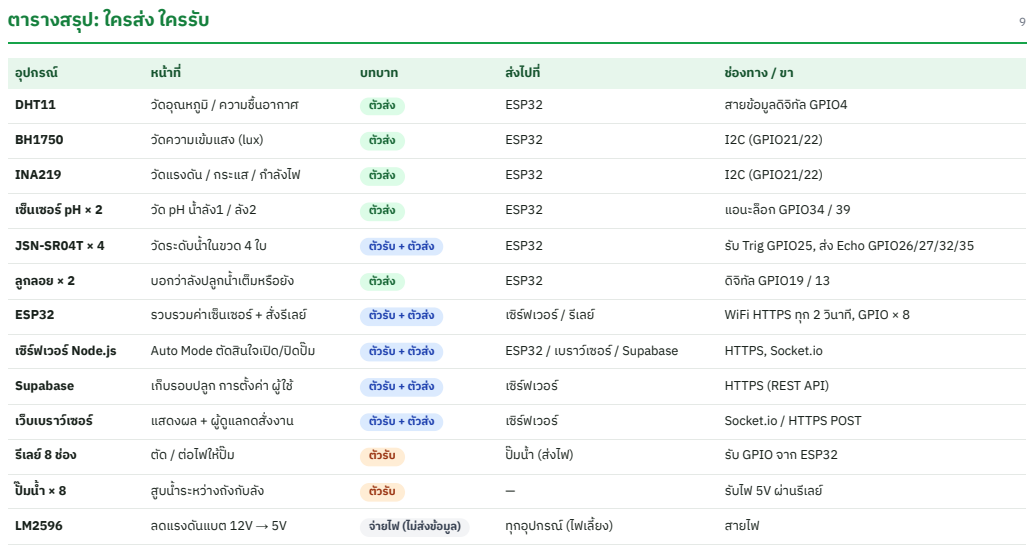
[picture p343: page 9]
อุปกรณ์; บทบาท; ส่งไปที่; ช่องทาง / ขา; DHT11; วัดอุณหภูมิ / ความชื้นอากาศ; ESP32; สายข้อมูลดิจิทัล GPIO4; วัดความเข้มแสง (lux); I2C (GPIO21/22); INA219; วัดแรงดัน / กระแส / กำ ลังไฟ; เซ็นเซอร์ pH × 2; แอนะล็อก GPIO34 / 39; JSN-SR04T × 4; วัดระดับน้ำ ในขวด 4 ใบ; รับ Trig GPIO25, ส่ง Echo GPIO26/27/32/35; ลูกลอย × 2; บอกว่าลังปลูกน้ำ เต็มหรือยัง; ดิจิทัล GPIO19 / 13; รวบรวมค่าเซ็นเซอร์ + สั่งรีเลย์; เซิร์ฟเวอร์ / รีเลย์; WiFi HTTPS ทุก 2 วินาที, GPIO × 8; เซิร์ฟเวอร์ Node.js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
