Warakorn456/project-sau/(commit log)

2026-05-15 Add user management with role-based access control
    - Add users.json storage with HMAC-SHA256 password hashing
    - Two roles: admin (full control) and viewer (monitor only)
    - Admin can manage users, control relays, change auto settings
    - Viewer can only monitor sensors, water levels, and charts
    - Add /api/me, /api/users CRUD endpoints
    - Show user badge and role tag in navbar
2026-06-17 Water level sensors working: SR04M-2 trigger/echo + I2C guard + crosstalk filter
    โปรเจกต์: ระบบปลูกผักไฮโดรโปนิกส์อัตโนมัติ (ESP32 + Node.js + Web dashboard)
    ESP32 อ่านเซ็นเซอร์ส่งไป cloud (project-sau.onrender.com) ทุก 5 วิ
    แก้ปัญหา "ค่าระดับน้ำไม่เข้า" ใน smart_farm.ino:
    - เดิมอ่านแค่ sensor ตัวเดียว -> อ่านครบ 7 ตัว
    - SR04M-2 จริงๆ เป็น trigger/echo (ไม่ใช่ UART ตามป้ายขา TX/RX)
    - ยิง trigger คร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
2026-06-18 fix: START button gives immediate visual feedback without waiting for Socket.io
    - Disable button + show "กำลังเริ่ม..." while API call is in progress
    - Optimistically update UI (START→STOP) right after API responds
    - Same fix for STOP button (STOP→START on success)
    - Revert button label on API error
    Previously the button appeared unresponsive because UI only updated
    on Socket.io programStatus event, which could be delayed or missed.
2026-06-19 Update PROGRESS.md — server fixes done, pH hardware status
2026-09-02 Stop tracking runtime crop-cycle data files in git
    data/crops/*.json is generated at runtime by cropCycles.js and was
    accidentally committed, leaking a crop cycle's data into the repo.
    Gitignore the whole data/ folder (mirrors history.json) and untrack
    the files that already slipped in; local/production copies are kept.
    Also documents the ephemeral-disk risk for this data on Railway/Render
    free tier in CLAUDE.md.
2026-10-24 Water cards: tap-to-toggle live distance mode showing raw sensor reading; share SENSOR_GAP_MM via sim-profiles
2026-10-26 PDF/charts: show grow-tray float switch as full/not full instead of mm
    - Export columns w3/w5 become float status; hourlyRows decides full when
    water was full more than half the hour (table, charts, coverage agree)
    - Float charts are stepped with a full/not-full Y axis; daily summary shows
    % of time full; manual entry uses a full/not-full select
    - Simulated data emits float values for trays without extra random draws
    - Tray cards keep simulated levels until firmware sends trayFloat
2026-10-26 Auto loop: every N minutes fill until float switch, soak, then drain
    - trayNIntervalMin (start-to-start) replaces trayNCycleHours; old hours
    values migrate x60 before merging with defaults
    - START / switching to AUTO starts filling immediately
    - Fill timeout without the float lifting stops the pump, raises a tray
    alert on the dashboard and drains straight away (no soak); without
    float data (old firmware) it soaks as before
    - Fresh-water refill R1/R2 removed from AUTO; float cutoff still guards them
    - Settings reject intervals shorter than fill + soak + drain
    - Control page fields ordered by loop step; status shows countdowns
